alex-absent/intercom/Screenshot_19.png

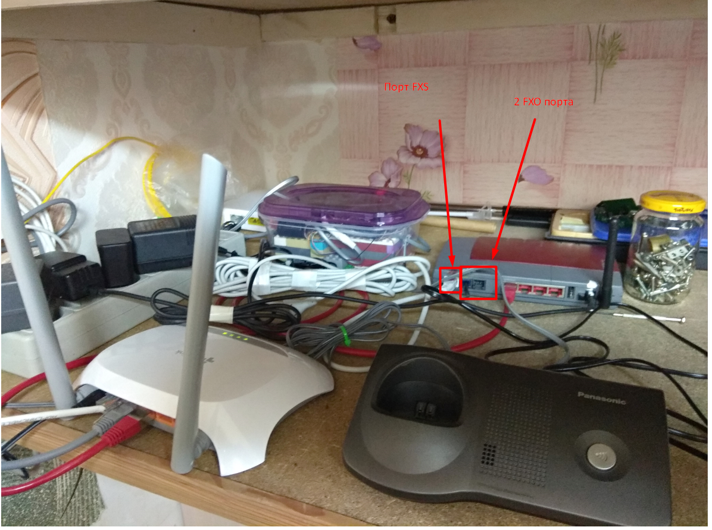
Screenshot_19.png
