alex-absent/intercom/Screenshot_2.png

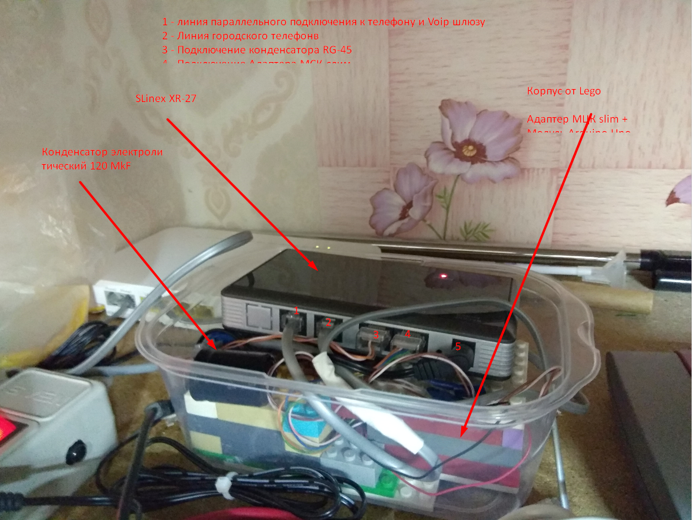
Screenshot_2.png
