alex-absent/intercom/Screenshot_20.png

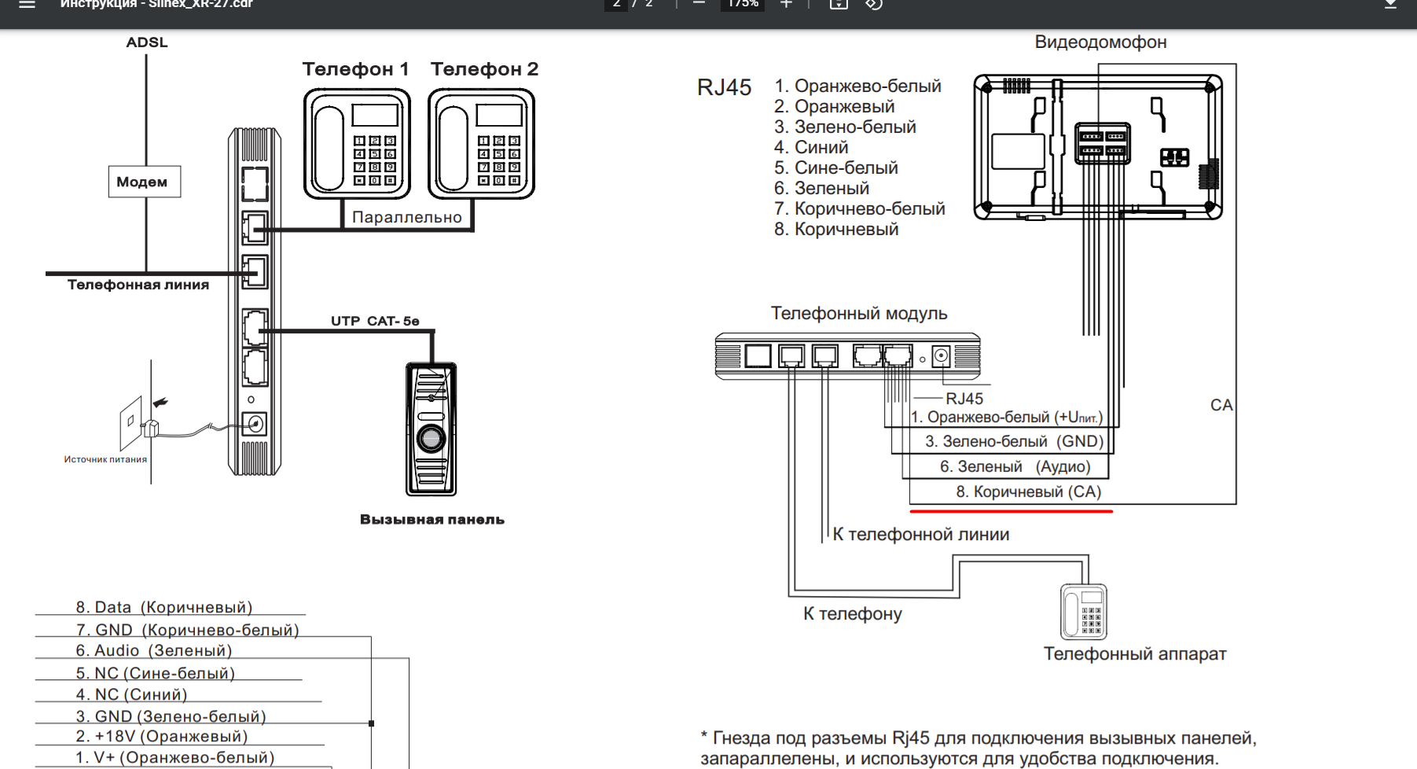
Screenshot_20.png
